GeoEduLab/3D-printed-Spectrometer/imagini/DBS23.png

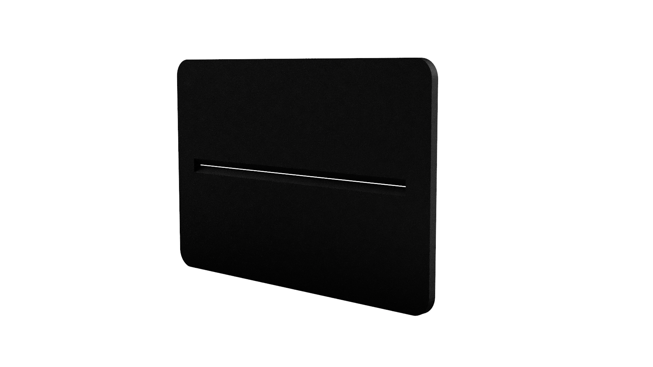
imagini/DBS23.png
