GeoEduLab/3D-printed-Spectrometer/imagini/Spectrometru_2026-Apr-17_04-58-26PM-000_CustomizedView25004581519.png

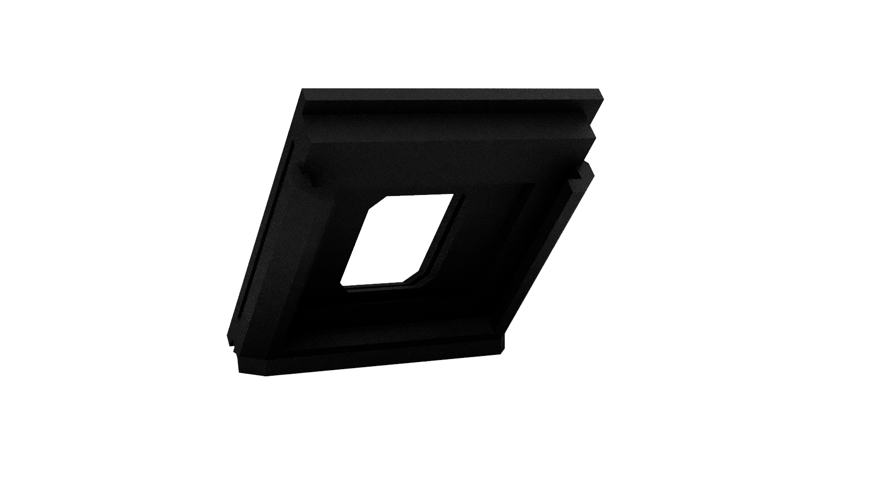
imagini/Spectrometru_2026-Apr-17_04-58-26PM-000_CustomizedView25004581519.png
