GeoEduLab/3D-printed-Spectrometer/imagini/Spectrometru_2026-Apr-17_04-58-39PM-000_CustomizedView1515149404.png

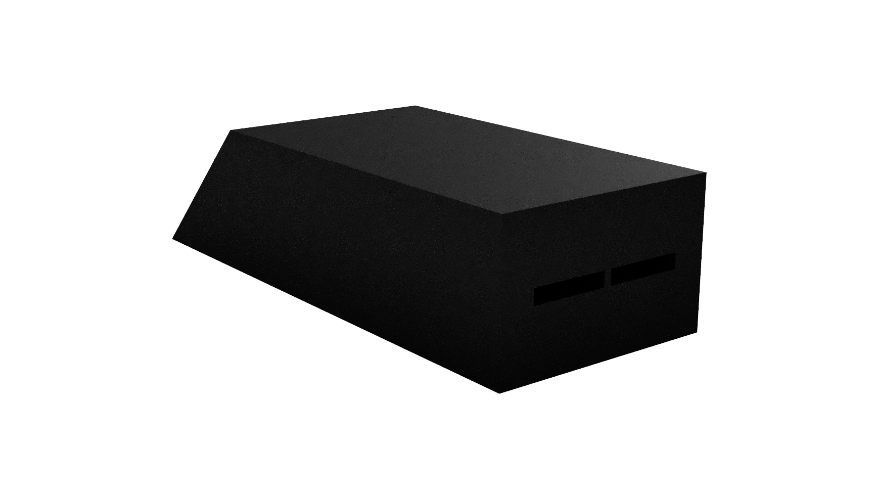
imagini/Spectrometru_2026-Apr-17_04-58-39PM-000_CustomizedView1515149404.png
