GeoEduLab/3D-printed-Spectrometer/imagini/Spectrometru_2026-Apr-17_04-59-10PM-000_CustomizedView14526760631.png

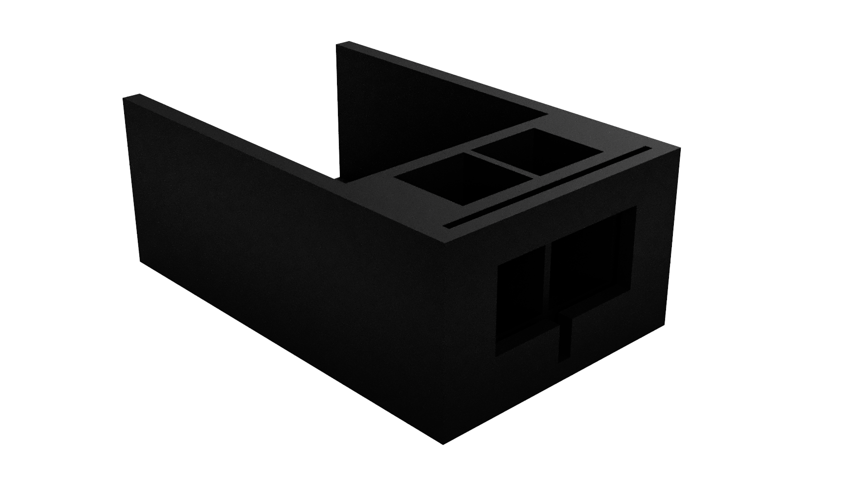
imagini/Spectrometru_2026-Apr-17_04-59-10PM-000_CustomizedView14526760631.png
