GeoEduLab/3D-printed-Spectrometer/imagini/Spectrometru_2026-Apr-17_04-59-59PM-000_CustomizedView1463442454.png

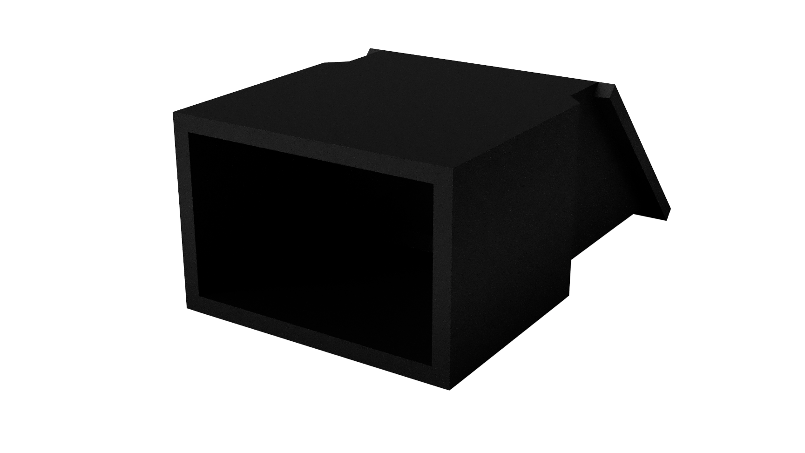
imagini/Spectrometru_2026-Apr-17_04-59-59PM-000_CustomizedView1463442454.png
