GeoEduLab/3D-printed-Spectrometer/imagini/Spectrometru_2026-Apr-17_05-00-21PM-000_CustomizedView18765208338.png

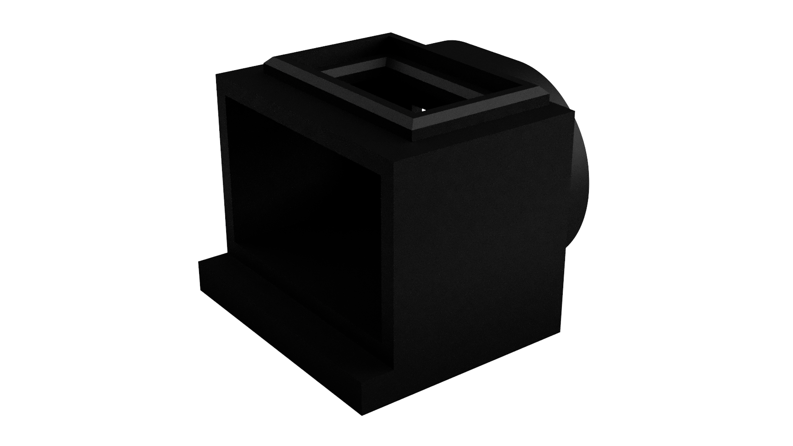
imagini/Spectrometru_2026-Apr-17_05-00-21PM-000_CustomizedView18765208338.png
