GeoEduLab/3D-printed-Spectrometer/imagini/Spectrometru_2026-Apr-17_05-00-52PM-000_CustomizedView15146700561.png

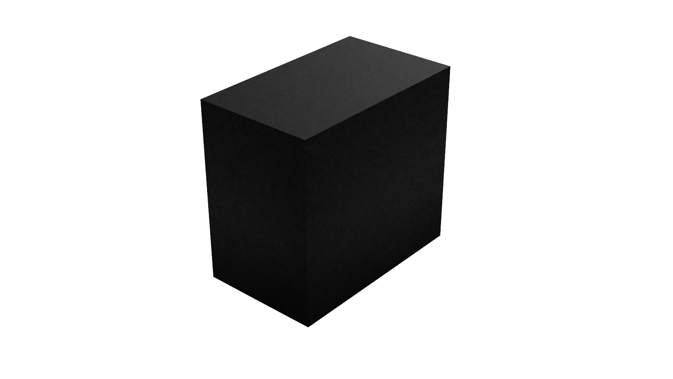
imagini/Spectrometru_2026-Apr-17_05-00-52PM-000_CustomizedView15146700561.png
