GeoEduLab/3D-printed-Spectrometer/imagini/Spectrometru_2026-Apr-17_05-02-09PM-000_CustomizedView38838320194.png

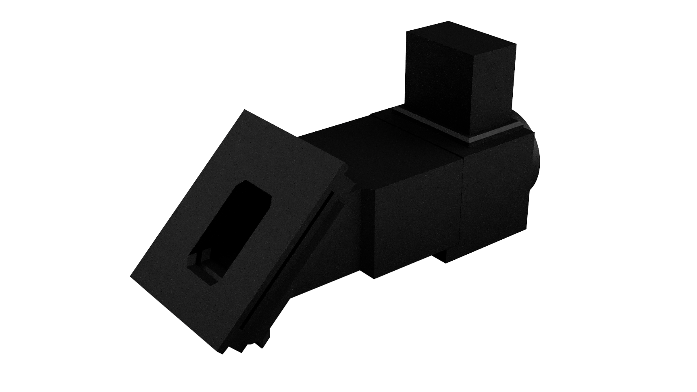
imagini/Spectrometru_2026-Apr-17_05-02-09PM-000_CustomizedView38838320194.png
