GeoEduLab/3D-printed-Spectrometer/imagini/Spectrometru_2026-Apr-17_05-02-24PM-000_CustomizedView2908652094.png

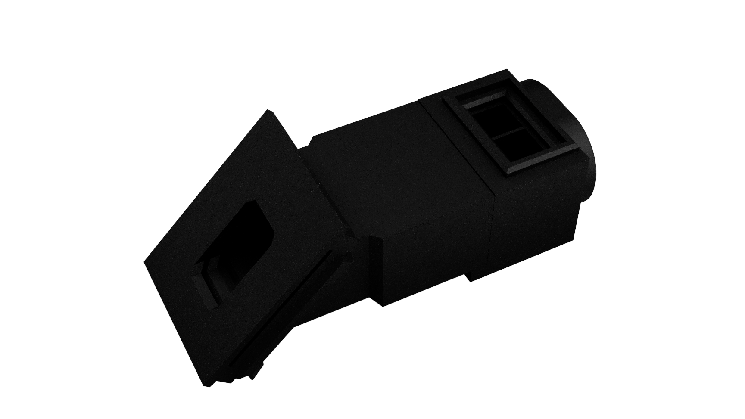
imagini/Spectrometru_2026-Apr-17_05-02-24PM-000_CustomizedView2908652094.png
