GeoEduLab/3D-printed-Spectrometer/imagini/Spectrometru_2026-Apr-17_05-02-41PM-000_CustomizedView4831055303.png

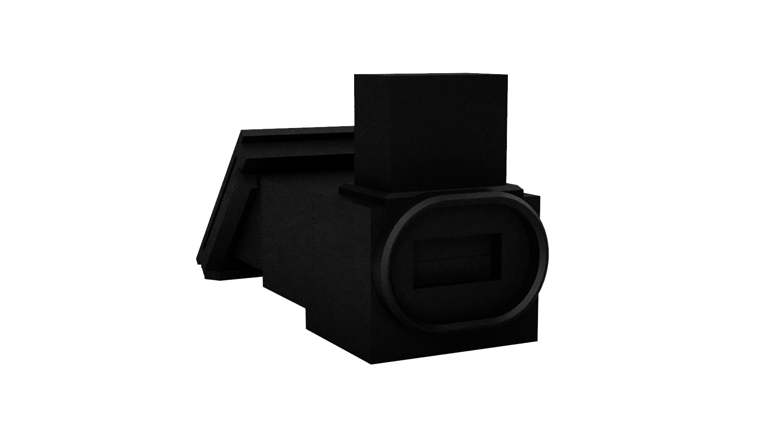
imagini/Spectrometru_2026-Apr-17_05-02-41PM-000_CustomizedView4831055303.png
