GeoEduLab/3D-printed-Spectrometer/imagini/Spectrometru_2026-Apr-17_05-03-23PM-000_CustomizedView4814271532.png

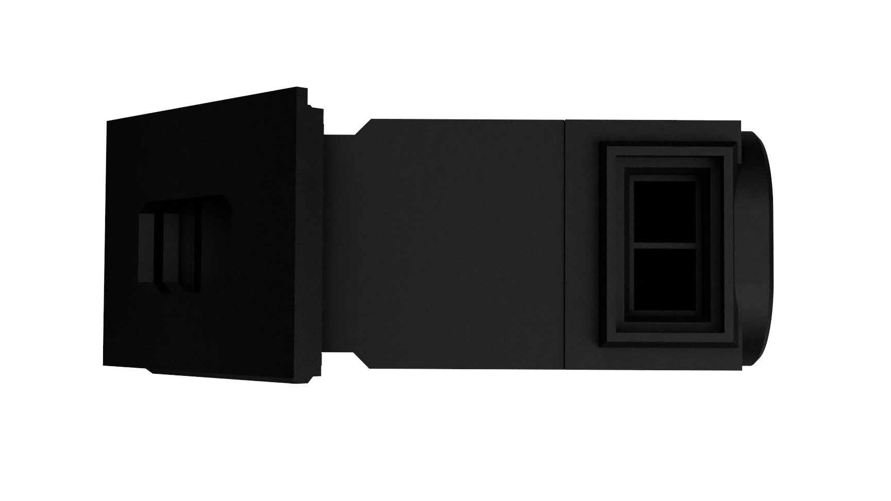
imagini/Spectrometru_2026-Apr-17_05-03-23PM-000_CustomizedView4814271532.png
