GeoEduLab/3D-printed-Spectrometer/imagini/Spectrometru_2026-Apr-17_05-08-17PM-000_CustomizedView8160718654.png

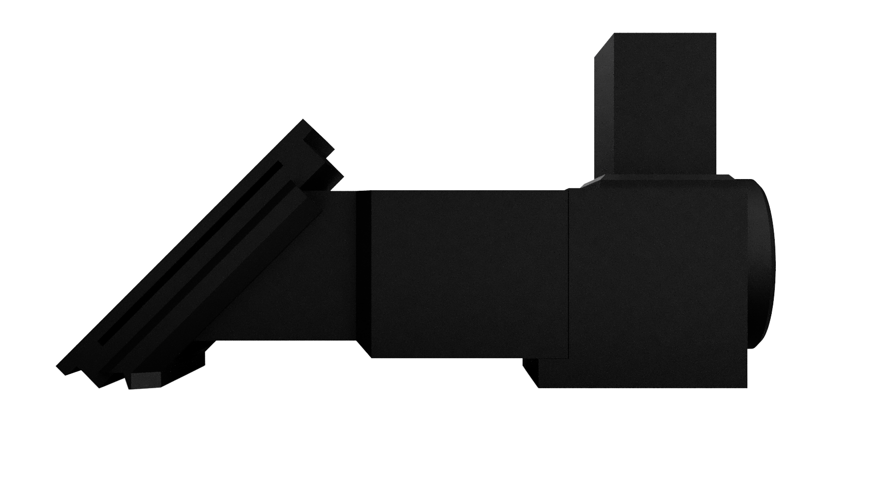
imagini/Spectrometru_2026-Apr-17_05-08-17PM-000_CustomizedView8160718654.png
