GeoEduLab/3D-printed-Spectrometer/imagini/Spectrometru_2026-Apr-17_05-12-23PM-000_CustomizedView19729545498.png

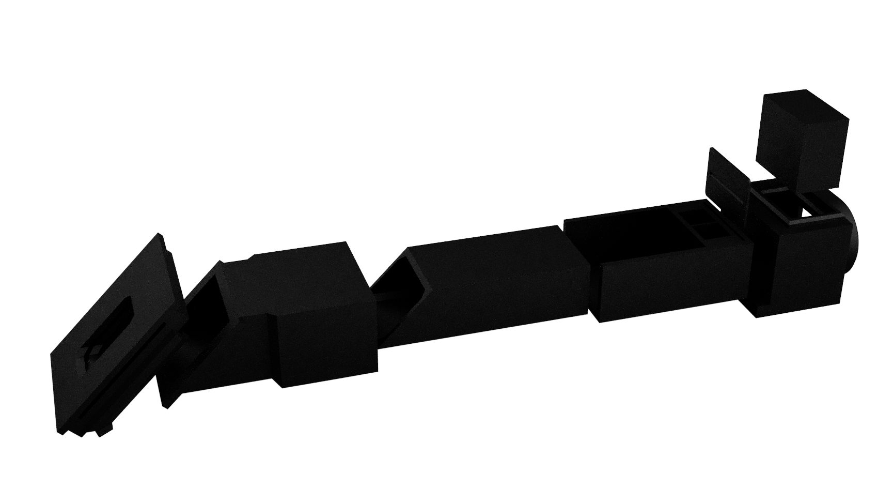
imagini/Spectrometru_2026-Apr-17_05-12-23PM-000_CustomizedView19729545498.png
