GeoEduLab/3D-printed-Spectrometer/imagini/Spectrometru_2026-Apr-17_05-12-49PM-000_CustomizedView16038114572.png

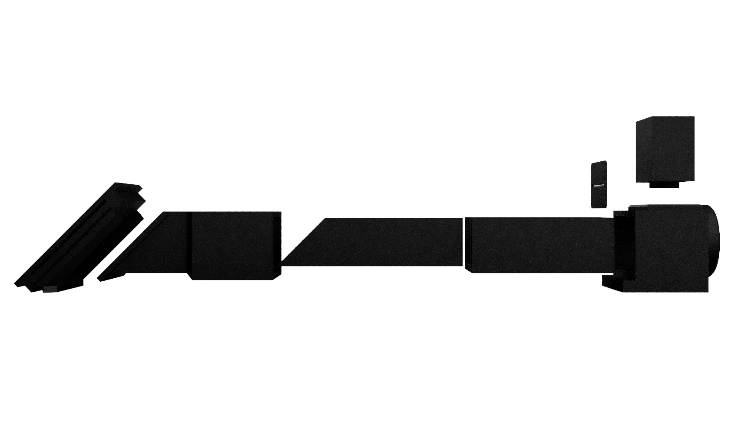
imagini/Spectrometru_2026-Apr-17_05-12-49PM-000_CustomizedView16038114572.png
