GeoEduLab/3D-printed-Spectrometer/imagini/Spectrometru_2026-Apr-17_05-12-56PM-000_CustomizedView32037252546.png

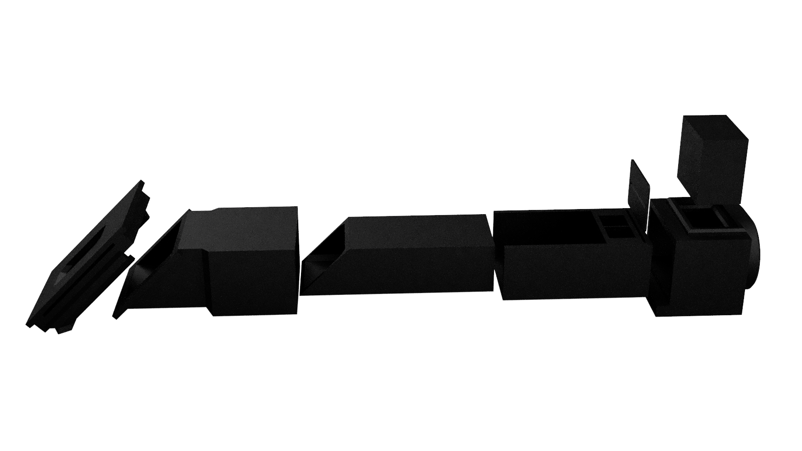
imagini/Spectrometru_2026-Apr-17_05-12-56PM-000_CustomizedView32037252546.png
