GeoEduLab/3D-printed-Spectrometer/imagini/Spectrometru_2026-Apr-17_05-13-06PM-000_CustomizedView11603945447.png

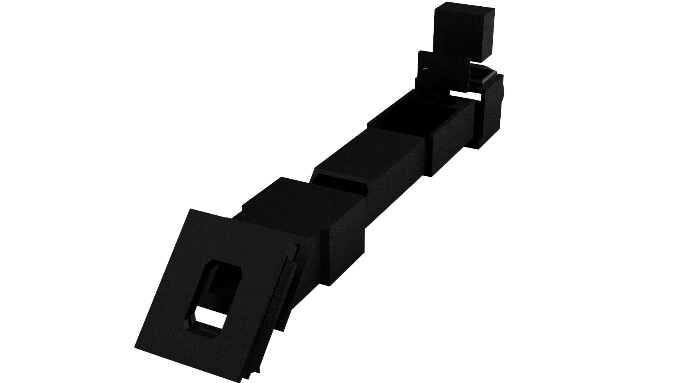
imagini/Spectrometru_2026-Apr-17_05-13-06PM-000_CustomizedView11603945447.png
