GeoEduLab/3D-printed-Spectrometer/imagini/Spectrometru_2026-Apr-17_05-13-27PM-000_CustomizedView9052108846.png

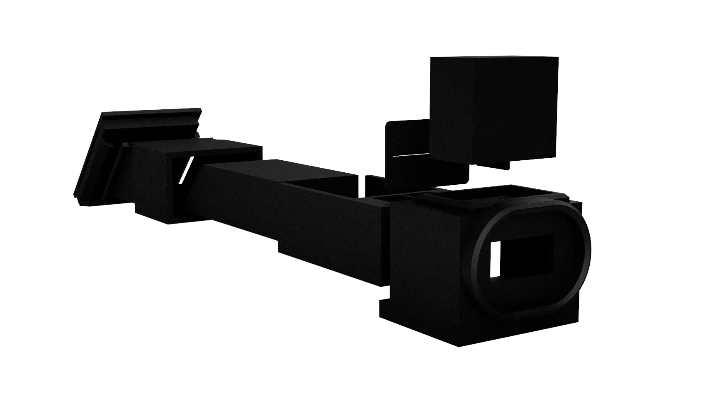
imagini/Spectrometru_2026-Apr-17_05-13-27PM-000_CustomizedView9052108846.png
