GeoEduLab/3D-printed-Spectrometer/imagini/Spectrometru_2026-Apr-17_05-33-20PM-000_CustomizedView31151100508.png

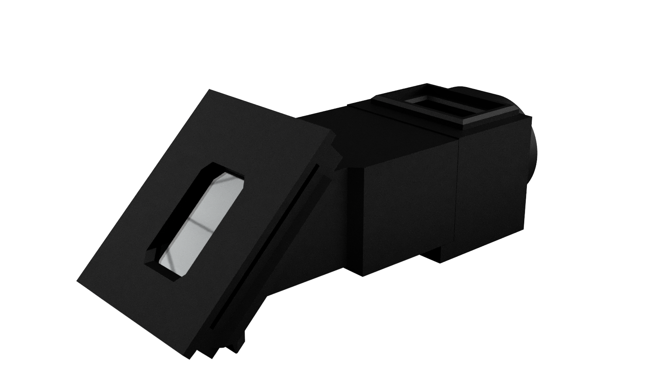
imagini/Spectrometru_2026-Apr-17_05-33-20PM-000_CustomizedView31151100508.png
