GeoEduLab/3D-printed-Spectrometer/imagini/Spectrometru_2026-Apr-17_05-33-32PM-000_CustomizedView8510036916.png

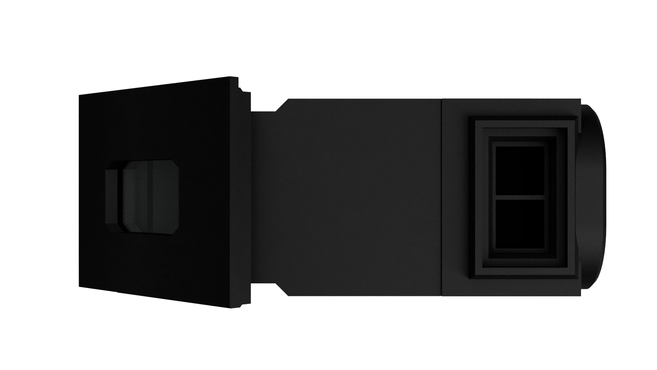
imagini/Spectrometru_2026-Apr-17_05-33-32PM-000_CustomizedView8510036916.png
