GeoEduLab/3D-printed-Spectrometer/imagini/Spectrometru_2026-Apr-17_05-35-06PM-000_CustomizedView794190731.png

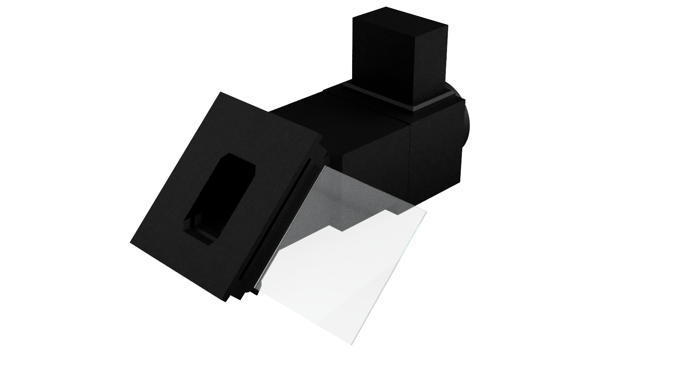
imagini/Spectrometru_2026-Apr-17_05-35-06PM-000_CustomizedView794190731.png
