GeoEduLab/3D-printed-Spectrometer/imagini/Spectrometru_2026-Apr-17_05-44-13PM-000_CustomizedView24996888186.png

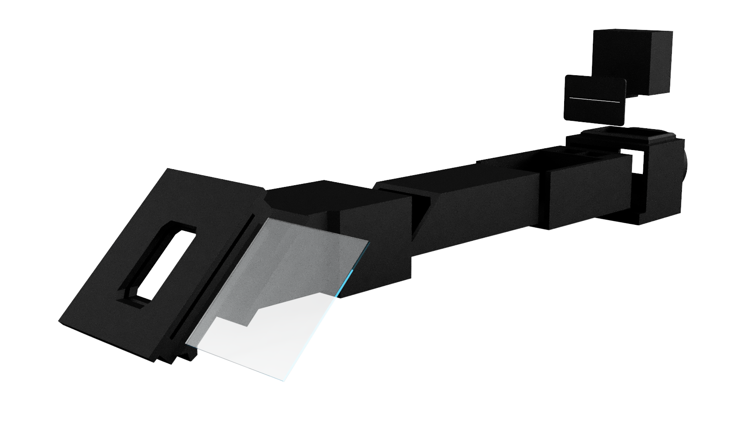
imagini/Spectrometru_2026-Apr-17_05-44-13PM-000_CustomizedView24996888186.png
