GeoEduLab/3D-printed-Spectrometer/imagini/Spectrometru_2026-Apr-17_05-44-50PM-000_CustomizedView3260356317.png

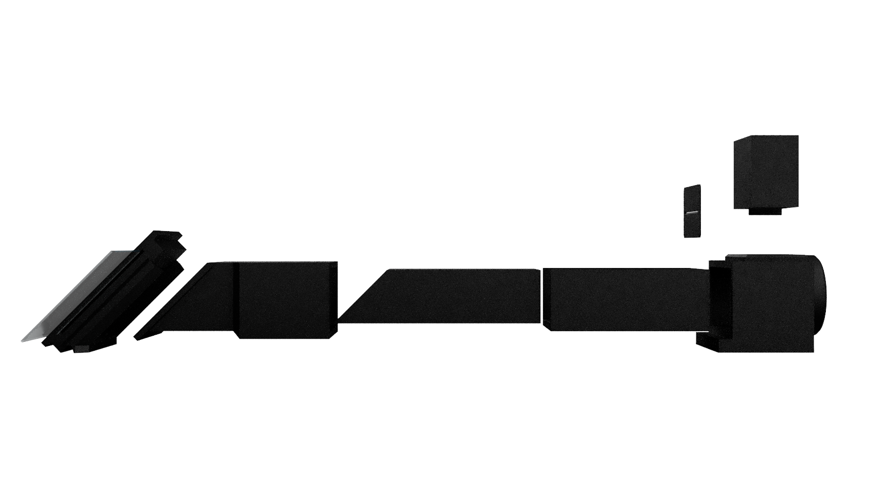
imagini/Spectrometru_2026-Apr-17_05-44-50PM-000_CustomizedView3260356317.png
