GeoEduLab/3D-printed-Spectrometer/imagini/Spectrometru_2026-Apr-17_05-45-26PM-000_CustomizedView59390768797.png

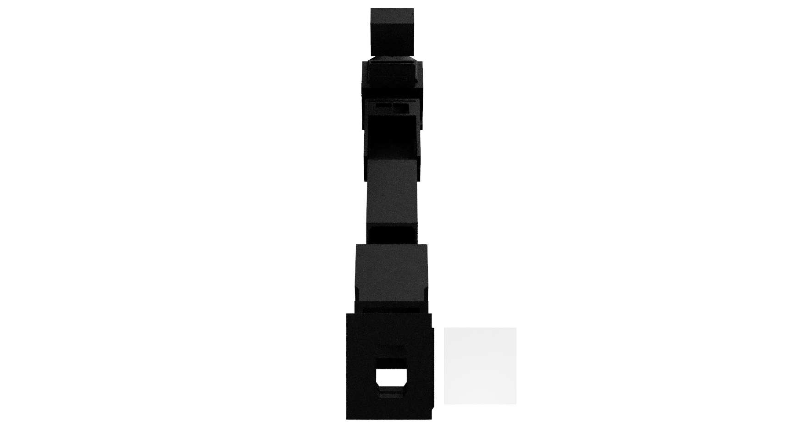
imagini/Spectrometru_2026-Apr-17_05-45-26PM-000_CustomizedView59390768797.png
