GeoEduLab/3D-printed-Spectrometer/new_parts/grating_frame/Ansamblu_rama_in_DBS03.png

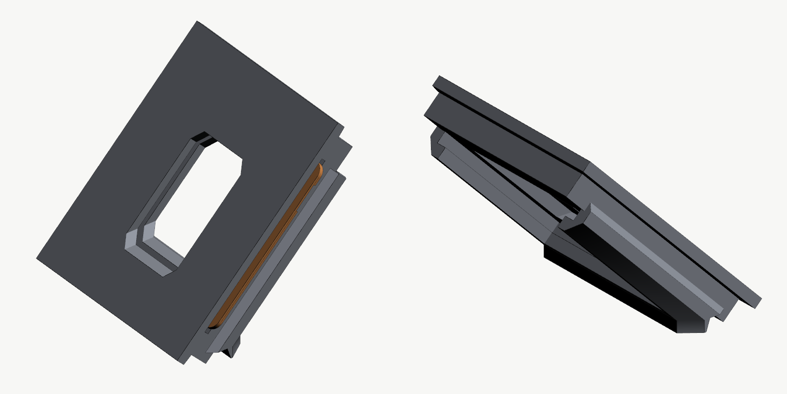
new_parts/grating_frame/Ansamblu_rama_in_DBS03.png
