GeoEduLab/3D-printed-Spectrometer/new_parts/slits/Ansamblu_fanta_in_DBS02.png

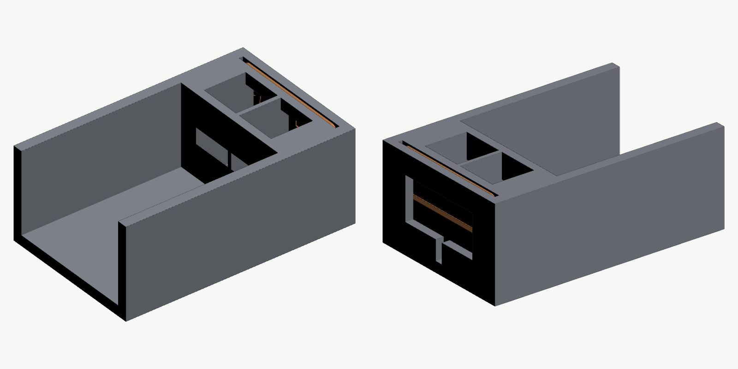
new_parts/slits/Ansamblu_fanta_in_DBS02.png
