GeoEduLab/3D-printed-Spectrometer/new_parts/grating_frame/jig_capac.stl

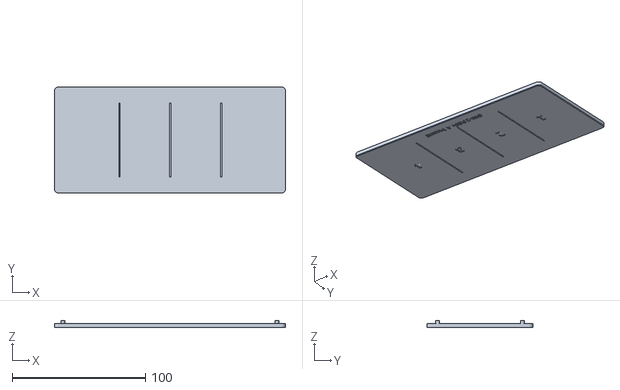
[picture p29: CAD file, 2026-11-09]
new_parts/grating_frame/jig_capac.stl
173.6 x 79.6 x 5.60
