GeoEduLab/3D-printed-Spectrometer/new_parts/slits/fanta_1.stl

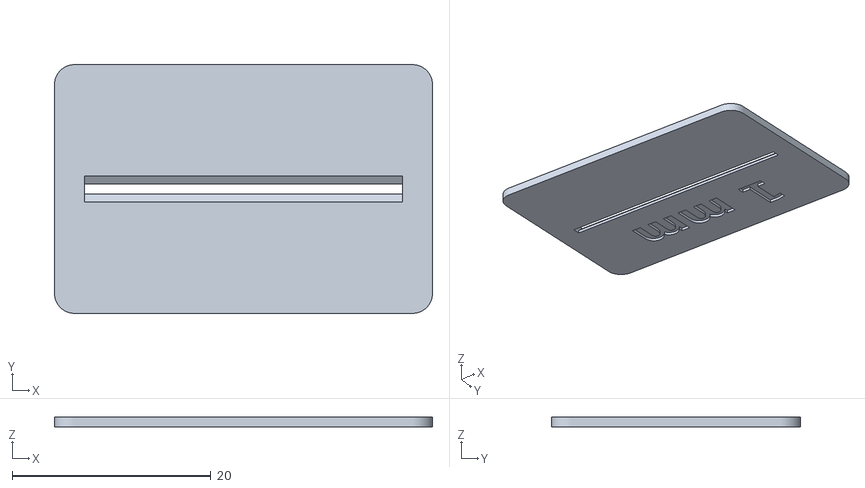
[picture p30: CAD file, 2026-11-09]
new_parts/slits/fanta_1.stl
38.0 x 25.0 x 1.00
