GeoEduLab/3D-printed-Spectrometer/new_parts/grating_frame/RamaRetea_4rame_v1.5_H2S.3mf

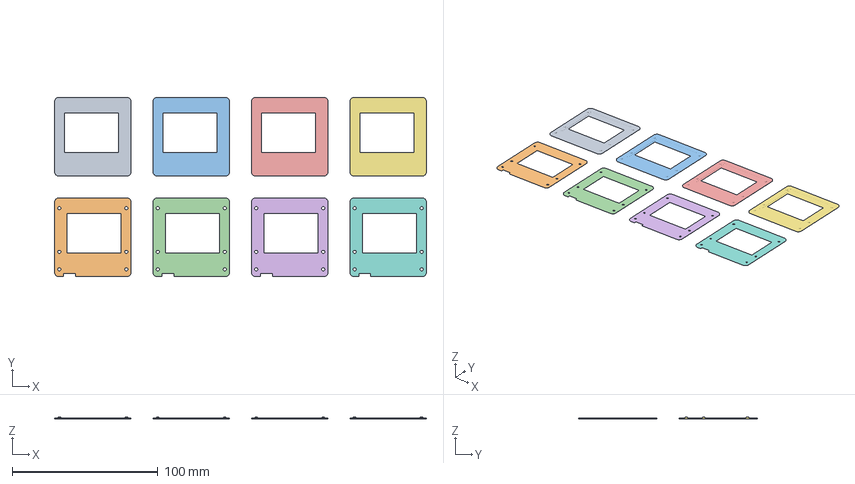
[picture p31: CAD file, 2026-11-09]
new_parts/grating_frame/RamaRetea_4rame_v1.5_H2S.3mf
255.4 x 123.1 x 1.28 mm
rama1_A
rama1_B
rama2_A
rama2_B
rama3_A
rama3_B
rama4_A
rama4_B
