GeoEduLab/3D-printed-Spectrometer/new_parts/grating_frame/jig_baza.stl

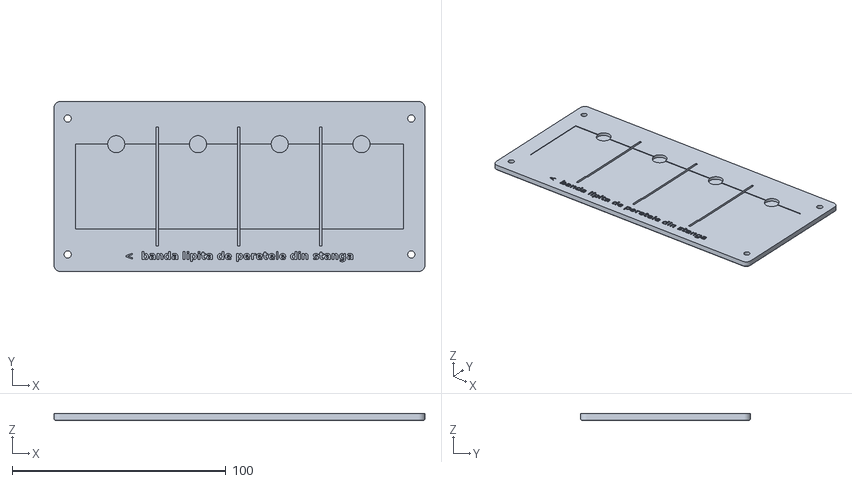
[picture p33: CAD file, 2026-11-09]
new_parts/grating_frame/jig_baza.stl
173.6 x 79.6 x 3.20
