GeoEduLab/3D-printed-Spectrometer/new_parts/slits/Fante_v0.5_H2S.3mf

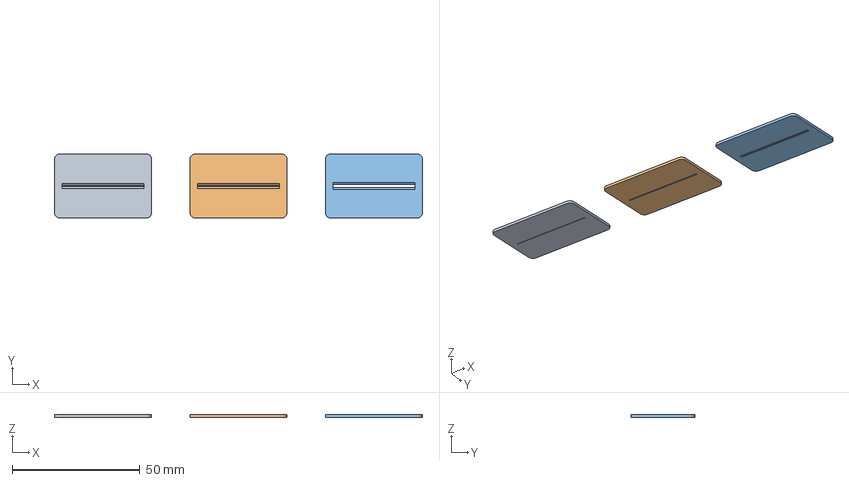
[picture p34: CAD file, 2026-11-09]
new_parts/slits/Fante_v0.5_H2S.3mf
144.0 x 25.0 x 1.00 mm
fanta_0.25
fanta_0.5
fanta_1
