GeoEduLab/3D-printed-Spectrometer/new_parts/grating_frame/rama_A.stl

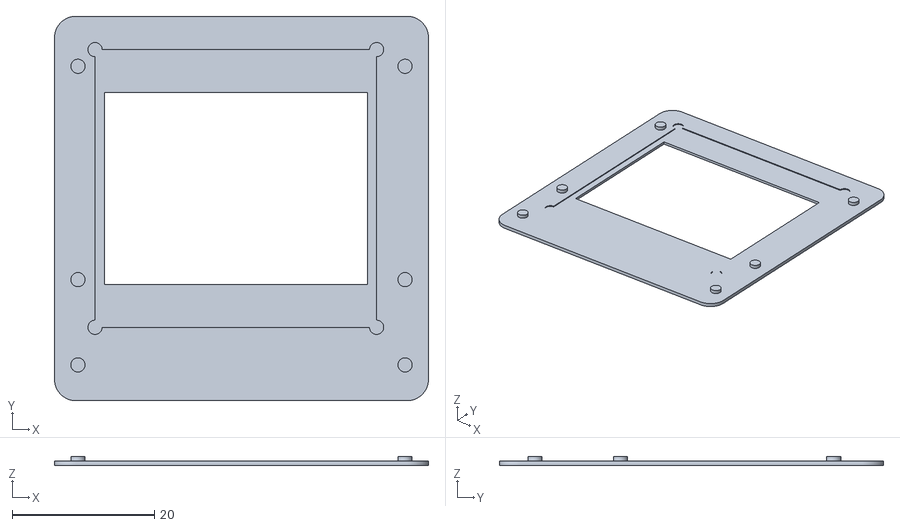
[picture p35: CAD file, 2026-11-09]
new_parts/grating_frame/rama_A.stl
52.6 x 54.0 x 1.28
