GeoEduLab/3D-printed-Spectrometer/new_parts/slits/Fante_proba12_v0.5_H2S.3mf

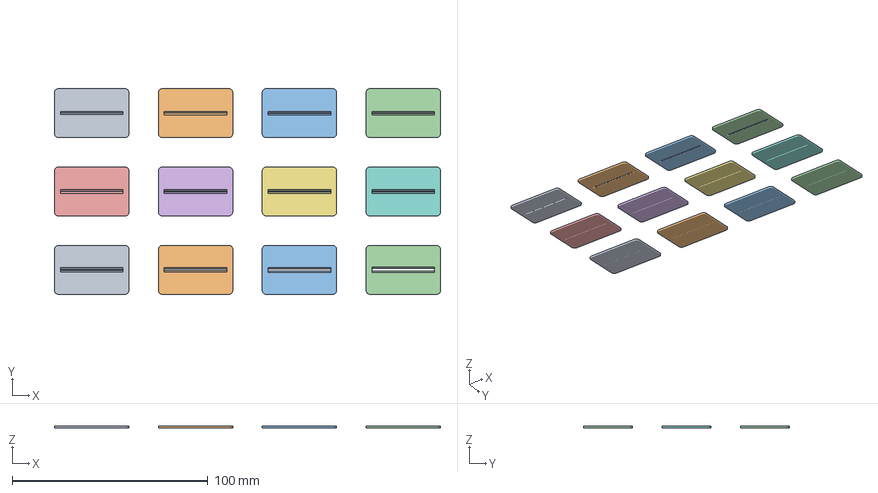
[picture p36: CAD file, 2026-11-09]
new_parts/slits/Fante_proba12_v0.5_H2S.3mf
197.0 x 105.0 x 1.00 mm
fanta_0.05
fanta_0.1
fanta_0.15
fanta_0.2
fanta_0.25
fanta_0.3
fanta_0.4
fanta_0.5
fanta_0.6
fanta_0.8
fanta_1
fanta_1.2
