GeoEduLab/3D-printed-Spectrometer/new_parts/grating_frame/RamaRetea_jig_v1.5_H2S.3mf

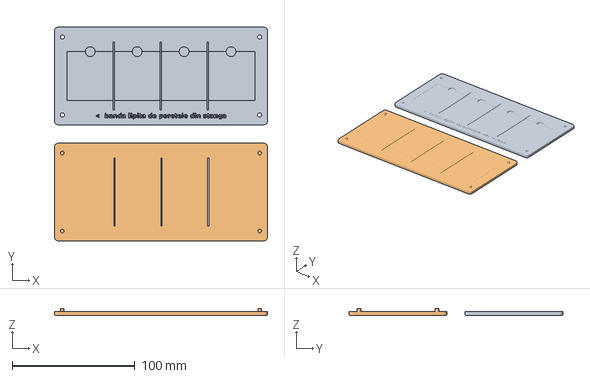
[picture p37: CAD file, 2026-11-09]
new_parts/grating_frame/RamaRetea_jig_v1.5_H2S.3mf
173.6 x 174.2 x 5.60 mm
geometry_0
geometry_1
