GeoEduLab/3D-printed-Spectrometer/new_parts/slits/fanta_0.25_text.stl

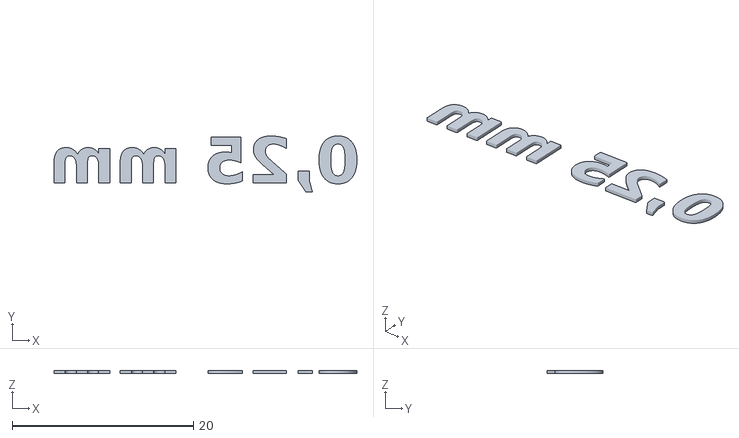
[picture p38: CAD file, 2026-11-09]
new_parts/slits/fanta_0.25_text.stl
33.4 x 6.19 x 0.36
