GeoEduLab/3D-printed-Spectrometer/new_parts/grating_frame/rama_B_text.stl

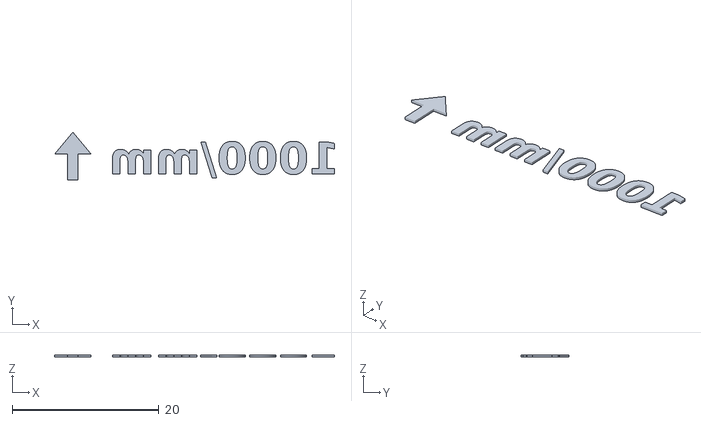
[picture p39: CAD file, 2026-11-09]
new_parts/grating_frame/rama_B_text.stl
38.1 x 6.50 x 0.32
