GeoEduLab/3D-printed-Spectrometer/new_parts/grating_frame/rama_B.stl

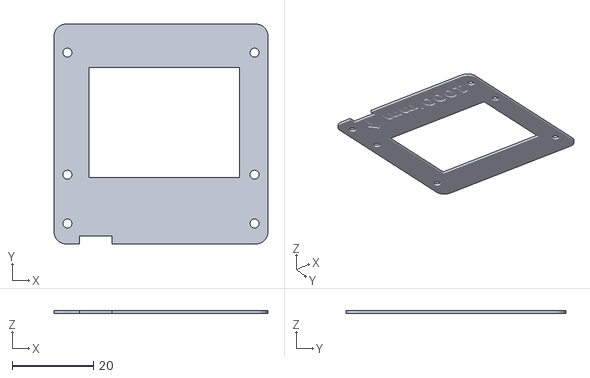
[picture p40: CAD file, 2026-11-09]
new_parts/grating_frame/rama_B.stl
52.6 x 54.0 x 0.64
