GeoEduLab/3D-printed-Spectrometer/new_parts/slits/fanta_1_text.stl

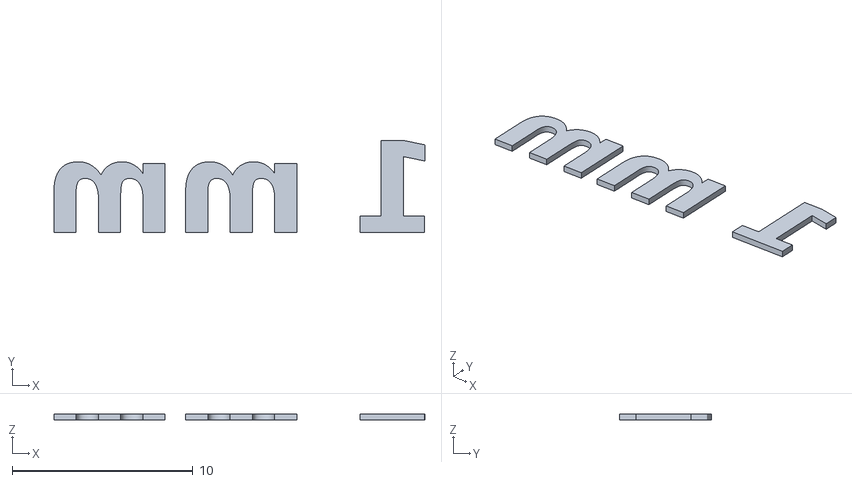
[picture p41: CAD file, 2026-11-09]
new_parts/slits/fanta_1_text.stl
20.6 x 5.10 x 0.36
