GeoEduLab/3D-printed-Spectrometer/new_parts/slits/fanta_0.5_text.stl

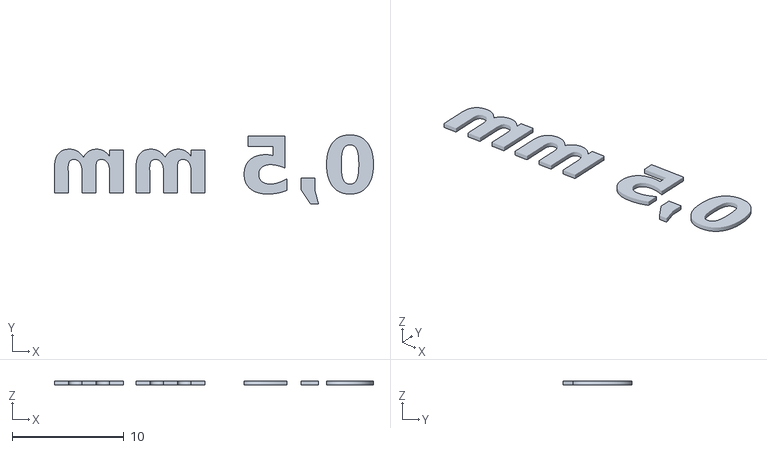
[picture p42: CAD file, 2026-11-09]
new_parts/slits/fanta_0.5_text.stl
28.5 x 6.19 x 0.36
