GeoEduLab/3D-printed-Spectrometer/(list of files, cad)

Other CAD files:
new_parts/slits/fanta_0.25.stl
new_parts/grating_frame/RamaRetea_jig_v1.5.3mf
new_parts/grating_frame/RamaRetea_4rame_v1.5.3mf
new_parts/slits/proba_latimi.3mf
new_parts/slits/Fante_0.25_0.5_1.3mf
