GeoEduLab/3D-printed-Spectrometer/Smartspectrometer-Manual-RO.pdf

# Spectrofotometrul cu dublă rază

Manual de asamblare și utilizare pentru elevi și profesori


Manual v1 · 2026 | Licență hardware: CC BY-SA 4.0

Bazat pe: Winters, B.J. et al. (2021). 3D-Printable and open-source modular smartphone visible spectrophotometer. HardwareX, 10, e00232. https://doi.org/10.1016/j.ohx.2021.e00232

Fișiere STL și documentație: https://osf.io/7ewb3

SMARTSPECTROMETER · GEO EDU LAB | 1
geoedulab.infp.ro | CC BY-SA 4.0

### Cuprins

1. Ce este lumina?
2. Ce este un spectrofotometru?
3. Cum funcționează spectrofotometrul nostru?
4. Componentele spectrofotometrului
5. Asamblarea pas cu pas
6. Cum măsurăm?
7. Calibrarea instrumentului
8. Experimente
9. Depanare: Ce fac dacă nu merge?
10. Referințe
SMARTSPECTROMETER · GEO EDU LAB | 2

### 1. Ce este lumina?

Lumina este o formă de energie care călătorește sub formă de unde electromagnetice. Ceea ce vedem cu ochii noștri, culorile curcubeului, de la violet la roșu, reprezintă doar o mică porțiune dintr-un spectru mult mai larg.

Lungimea de undă (nm):
100 | 400 | 450 | 500 | 550 | 600 | 650 | 700 | 1000+
[UV extrem] [Violet][Albastru][Verde][Galben][Portocaliu][Roșu] [Infraroșu] ←——————— Vizibil pentru ochiul uman (380–700 nm) ————————→

💡 Știați că? Curcubeul nu este altceva decât lumina soarelui separată în culorile sale componente de picăturile de ploaie, care acționează ca niște prisme minuscule. Spectrofotometrul nostru face același lucru, dar în laborator!

💡 Știați că? Corpul uman emite lumină! Orice obiect cu o temperatură mai mare de −273°C (zero absolut) emite radiație electromagnetică. Corpul uman, la ≈37°C, emite lumină infraroșie, invizibilă ochiului, dar detectabilă cu camere termice. Acest fenomen se numește radiație de corp negru (black body radiation), descris de fizicianul Max Planck în 1900.
Cu cât un obiect este mai cald, cu atât lungimea de undă dominantă este mai scurtă:

Corpul uman (≈37°C) → infraroșu (≈9.000 nm)
Un fier înroșit (≈700°C) → roșu vizibil (≈700 nm)

Soarele (≈5.500°C) → galben-verde (≈500 nm)

O stea albastră fierbinte (≈20.000°C) → ultraviolet

Spectroscopia ne permite să „citim" temperatura și compoziția chimică a oricărei surse de lumină!

SMARTSPECTROMETER · GEO EDU LAB | 3

### 2. Ce este un spectrofotometru?

Un spectrofotometru este un instrument care:

1. Separă lumina în culorile sale componente (spectru)
2. Măsoară cât de multă lumină absoarbe sau emite o substanță la fiecare culoare (lungime de undă)

Există două tipuri principale de măsurători pe care le putem face:

Tip de
spectroscopie
| Ce măsurăm | Exemple
Emisie | Lumina produsă direct de o sursă | Becuri, flăcări, plasma, stele
Absorbție | Lumina absorbită de o substanță transparentă | Soluții colorate, filtre, clorofilă

💡 Știați că? Fiecare atom are o „amprentă digitală" de lumină! Atomii emit și absorb lumină numai la anumite lungimi de undă precise, ca un cod de bare unic. Aceasta a permis oamenilor de știință să descopere elementele chimice din Soare și stele fără să le viziteze vreodată! De exemplu, heliul a fost descoperit mai întâi pe Soare (în 1868) și abia 27 de ani mai târziu pe Pământ.

Această capacitate face spectrofotometrul util în:

Chimie: determinarea concentrației soluțiilor Biologie: analiza pigmenților, clorofilei, proteinelor

Astronomie: identificarea elementelor din stele Criminalistică: analiza urmelor de substanțe
Industria alimentară: controlul calității

Spectrofotometrele comerciale costă între 400 și 6.000 de euro [1]. Cel pe care îl construim noi costă aproximativ 25 de euro pentru piese și folosește smartphone-ul ca detector, fără să sacrifice precizia [1].

SMARTSPECTROMETER · GEO EDU LAB | 4

### 3. Cum funcționează spectrofotometrul nostru?

Spectrofotometrul DBS (Double-Beam Spectrophotometer, Spectrofotometru cu Dublă Rază) funcționează astfel:

SURSA DE LUMINA
│
▼
[Fanta ingusta] ← cartonas tiparit 3D (0,25 / 0,5 / 1 mm) │
│ raza 1 → trece prin PROBA (solutia de analizat) [Suport proba]
│ raza 2 → trece prin REFERINTA (apa pura / solvent)
│
▼
[Retea de difractie] ← 1000 linii/mm; separa culorile ca o prisma │
▼
[Camera smartphone / USB]
│
▼
[Software ImageJ] → grafic intensitate vs. lungime de unda
[Ochi] | → spectru vizibil direct in imagine

Notă pentru spectroscopia de emisie: Când studiem lumina emisă direct de o sursă (bec, flacără, plasmă), nu mai este nevoie de cuve cu probe. Îndreptăm spectrofotometrul direct spre sursă și observăm spectrul de emisie al acesteia.

Ce este rețeaua de difracție?

O rețea de difracție este o suprafață cu mii de linii paralele gravate pe milimetru. Când lumina lovește aceste linii, diferitele lungimi de undă (culori) sunt deviate în unghiuri diferite, exact ca o prismă, dar mai eficient. Rețeaua noastră are 1000 de linii pe milimetru [1].

De ce „dublă rază"?

Designul cu două raze este esențial pentru precizie în spectroscopia de absorbție [1]:

Raza superioară trece prin proba de analizat
Raza inferioară trece prin referință (apă pură sau solvent)
SMARTSPECTROMETER · GEO EDU LAB | 5

Camera captează ambele raze simultan în aceeași imagine. Comparând cele două spectre, eliminăm erorile cauzate de fluctuațiile sursei de lumină.

Legea Beer-Lambert: relația dintre culoare și concentrație

Cu cât o soluție este mai concentrată, cu atât absoarbe mai multă lumină. Această relație este descrisă prin Legea Beer-Lambert [1]:

Absorbanță (A) = −log₁₀ (P / P₀)

P₀ = intensitatea luminii de referință

P = intensitatea luminii după ce trece prin probă Absorbanță = 1 → proba a absorbit 90% din lumină Absorbanță = 2 → proba a absorbit 99% din lumină

SMARTSPECTROMETER · GEO EDU LAB | 6

### 4. Componentele spectrofotometrului

Spectrofotometrul este format din piese imprimate 3D și câteva componente achiziționate. Iată piesele principale:

### 4.1 Tubul fantă (DBS01)


Tub dreptunghiular alungit cu capătul tăiat în unghi; fața oblică permite intrarea luminii din fantă și o

îndreaptă spre probă.

Rol: Ghidează lumina de la sursă spre probă, menținând fasciculul îngust și drept. Se montează în Suportul probă și se interblocă cu Adaptorul tub (DBS04) pentru rigiditate.

### 4.2 Suportul probă și suportul fantei (DBS02)


Bloc dreptunghiular masiv cu două compartimente vizibile în partea dreaptă sus; acestea sunt sloturile pentru cuvele cu probă și referință. DBS02 găzduiește totodată cartonașul cu fantă.

Rol: Piesa centrală a instrumentului. Conține două sloturi pentru cuve (probă și referință) și găzduiește direct cartonașul cu fantă. Lumina trece prin fantă și prin ambele cuve simultan, creând cele două raze.

### 4.3 Suportul rețelei de difracție (DBS03)

SMARTSPECTROMETER · GEO EDU LAB | 7


Placă dreptunghiulară cu o fereastră/deschidere centrală prin care se introduce rețeaua de difracție.

Marginile în trepte asigură fixarea precisă a unghiului față de fasciculul de lumină.

Rol: Ține rețeaua de difracție (foița cu 1000 linii/mm) în unghiul corect față de fasciculul de lumină. Pe el se montează și suportul pentru cameră/smartphone.

### 4.4 Adaptorul tub (DBS04)


Cutie cubică cu o față tăiată în unghi și deschisă; creează camera întunecată dintre suportul probei și rețeaua de difracție, izolând fasciculul de lumina ambientală.

Rol: Face legătura mecanică între Suportul probă și Suportul rețelei de difracție. Tubul fantă (DBS01) se prelungește prin acesta și se interblocă cu DBS03, asigurând rigiditate și etanșeitate la lumina ambientală [1].

### 4.5 Adaptorul sursă (DBS05)


Bloc cubic cu o deschidere ovală pe fața frontală (pentru sursa de lumină) și un mâner/suport pe partea

superioară. Forma ovală centrează fasciculul de lumină spre fantă.

SMARTSPECTROMETER · GEO EDU LAB | 8

Rol: Se montează pe capătul suportului probă dinspre sursa de lumină. Adaptează diferite tipuri de surse (lanternă, stilou LED) la corpul instrumentului.

### 4.6 Cartonașele cu fantă (0,25 / 0,5 / 1 mm)


Trei cartonașe tipărite 3D, de 38 × 25 × 1 mm, fiecare cu o fantă de 32 mm lungime și lățimea gravată pe el. Se pun în locașul fantei din Suportul probă (DBS02), înaintea probei. Fișierele sunt în dosarul

new_parts/slits al acestui repository.

Rol: Cartonașul are fanta de lumină, cea mai delicată parte a instrumentului. Lățimea fantei determină rezoluția spectrală: o fantă îngustă dă linii mai subțiri, dar lasă să treacă mai puțină lumină.

De ce 0,25 / 0,5 / 1 mm: imprimanta (duza de 0,4 mm) închide complet o fantă de 0,05 mm. De la 0,1 mm în sus golul tipărit urmează desenul, dar pe piesă iese ceva mai îngust, iar sub ~0,2 mm marginile se pot lipi. De aceea cea mai îngustă fantă are 0,25 mm, iar fiecare următoare e de două ori mai lată, ca diferența să se vadă cu ochiul.

💡 Experimentați! Măsurați același bec cu toate trei cartonașele și comparați lățimea liniilor și cât de luminos e spectrul. Cu cartonașul de probă (12 lățimi, de la 0,05 la 1,2 mm) puteți afla ce lățimi deschide de fapt imprimanta voastră: îl țineți în fața unui bec și păstrați fantele deschise pe toată lungimea.

### 4.7 Cuve (CV01)

SMARTSPECTROMETER · GEO EDU LAB | 9

Cuve de unică folosință din PMMA (Polimetacrilat de metil), volum 2,5–4,5 ml, cu drum optic standard de 10

mm.

Rol: Conțin probele lichide (și soluția de referință) în timpul măsurătorilor de absorbție. Cuvele PMMA sunt transparente în domeniul vizibil (380–700 nm) și sunt de unică folosință, prevenind contaminarea încrucișată între experimente.

### 4.8 Rama rețelei de difracție și jig-ul de tăiat

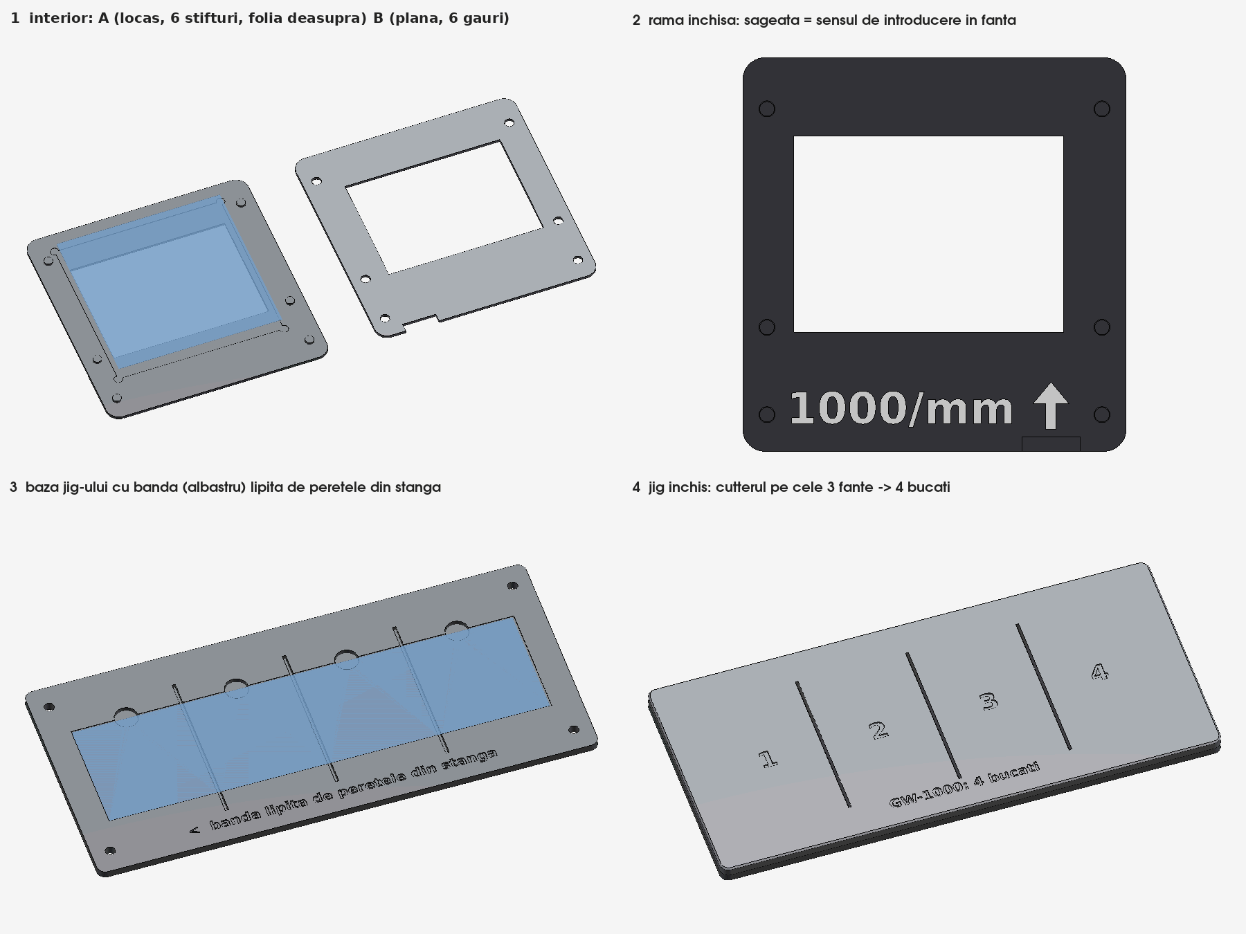
[picture p80: figure]

Rama tipărită din două jumătăți (A cu locaș și 6 știfturi, B plană cu scrisul alb „1000/mm" și o săgeată) și jig-ul care taie banda de folie în 4 bucăți egale. Fișierele sunt în dosarul new_parts/grating_frame .

Rol: Ține bucata de folie de difracție (AstroMedia GW-1000, 1000 linii/mm) plană și la locul ei în fanta laterală a lui DBS03, în locul ramei de carton din kit. Fereastra de 37 × 27 mm e centrată pe deschiderea lui DBS03, iar capătul cu crestătură rămâne ~2 mm afară, ca să scoateți rama ușor.

SMARTSPECTROMETER · GEO EDU LAB | 10

### 5. Asamblarea pas cu pas

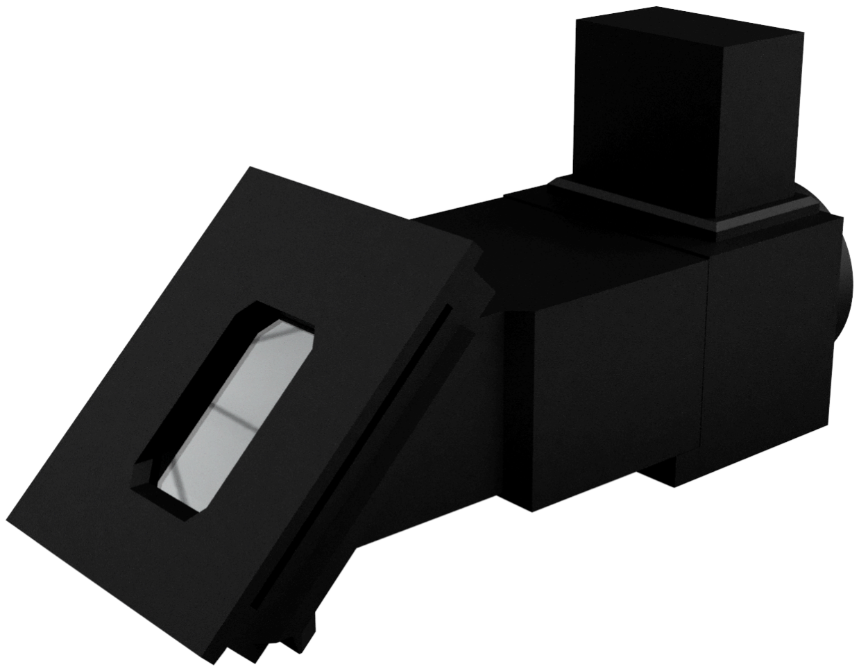
[picture p81: figure]

Spectrofotometrul complet asamblat. Se observă fanta de lumină (deschiderea dreptunghiulară albă) pe fața frontală și suportul pentru cameră/smartphone montat deasupra corpului principal.

Pasul 0: Pregătirea rețelei de difracție (rama și jig-ul)

Ai nevoie de: banda de folie GW-1000 (153 × 39 mm), jig-ul (bază + capac), o ramă (jumătățile A și B), un cutter, o pensetă

0a. Puneți banda în buzunarul bazei jig-ului și împingeți-o în peretele din stânga (săgeata gravată). Țineți folia doar de margini.

0b. Puneți capacul: cele 4 știfturi intră în găurile bazei, iar cifrele 1–4 trebuie să se citească corect.

0c. Trageți cutterul prin fiecare din cele 3 fante; lama coboară într-un canal din bază și taie folia până la capăt. Ridicați bucățile (38,25 × 39 mm) cu penseta.

0d. Puneți o bucată în locașul din jumătatea A și apăsați B peste A, cu scrisul în afară. Știfturile intră presat, fără lipici.

Rezultat: Rama cu rețeaua este gata. Din bandă ies 4 rame. ✓

Pasul 1: Montarea cartonașului cu fantă

Ai nevoie de: DBS02 (1×), un cartonaș cu fantă (0,25, 0,5 sau 1 mm; pentru început 0,5 mm)

SMARTSPECTROMETER · GEO EDU LAB | 11

1a. Verificați că DBS02 și cartonașul sunt curate și fără bavuri după imprimare, iar fanta se vede deschisă pe toată lungimea când țineți cartonașul spre un bec.

1b. Introduceți cartonașul în locașul fantei din DBS02, înaintea poziției probei. Fanta trebuie să fie orizontală.

1c. Împingeți până la fund: cartonașul rămâne puțin sub marginea lui DBS02. Pentru schimbare, scoateți-l întorcând DBS02.

Rezultat: Cardul cu fantă este montat; lumina va trece prin fanta imprimată spre cuve. ✓

💡 Alternativă: Puteți decupa și o fantă din carton negru cu un cutter, pentru a o compara cu cele tipărite.

Pasul 2: Asamblarea corpului principal

Ai nevoie de: subansamblul de la Pasul 1, DBS01, DBS03, DBS04, DBS05, rama cu rețeaua (Pasul 0)

2a. Verificați că DBS02 are cartonașul cu fantă montat (Pasul 1).

2b. Introduceți DBS01 (Tubul fantă) în DBS02 în orientarea corectă (consultați Fig. 4 din articol [1]).

2c. Montați DBS03 pe DBS04, apoi introduceți acest ansamblu pe DBS02 + DBS01. Tubul DBS01 se va prelungi dincolo de DBS04, interblocând totul; aceasta asigură rigiditate și etanșeitate la lumina ambientală [1].

2d. Introduceți rama cu rețeaua în fanta laterală a lui DBS03, cu vârful săgeții înainte, până la fund; capătul cu crestătură rămâne ~2 mm afară.

⚠️ Important: Liniile rețelei trebuie să fie orizontale în DBS03. Locașul ramei primește bucata de folie în ambele orientări, așa că verificați la un bec înainte de măsurători: dacă spectrul iese greșit, desfaceți rama și rotiți bucata cu 90°.

2e. Introduceți DBS05 (Adaptorul sursă) pe capătul opus al DBS02.

2f. Apăsați ansamblul din ambele capete pentru a vă asigura că toate piesele sunt bine fixate.

Rezultat: Instrumentul de bază este complet asamblat! ✓

SMARTSPECTROMETER · GEO EDU LAB | 12


Spectrofotometru complet asamblat. Fanta de lumină (deschiderea dreptunghiulară albă) este vizibilă pe fața

frontală, cu suportul pentru cameră/smartphone montat pe partea superioară a corpului principal.

SMARTSPECTROMETER · GEO EDU LAB | 13

### 6. Cum măsurăm?

### 6.1 Spectroscopia de emisie (fără cuve)

Folosită pentru a studia lumina produsă direct de o sursă (bec, flacără, LED, tub de descărcare).

Procedură:

1. Îndreptați spectrofotometrul spre sursa de lumină
2. Porniți camera și așteptați 30 de secunde ca imaginea să se stabilizeze
3. Capturați imaginea; veți vedea banda colorată a spectrului de-a lungul imaginii
4. Dacă imaginea este supraexpusă (albă), reduceți ISO-ul sau timpul de expunere al camerei

### 6.2 Spectroscopia de absorbție (cu cuve)

Folosită pentru a studia cât de multă lumină absoarbe o soluție.

Pregătirea probei:

Umpleți o cuvă cu proba (soluția de analizat)
Umpleți o altă cuvă cu referința (apă pură sau solventul pur)
Plasați cuva cu proba în slotul superior, referința în slotul inferior al DBS02

Capturarea imaginii:

1. Porniți sursa de lumină (lanternă sau stilou LED alb)
2. Așteptați 30 de secunde
3. Capturați imaginea; trebuie să fie vizibile ambele benzi spectrale (proba sus, referința jos)

### 6.3 Software și extragerea datelor

ImageJ, gratuit, open-source, disponibil la https://imagej.nih.gov/

1. Deschideți imaginea capturată în ImageJ
2. Cu instrumentul Rectangle, selectați o bandă orizontală de 200 pixeli înălțime pe toată lățimea imaginii
3. Mergeți la Analyze → Plot Profile (sau apăsați Ctrl+K)
4. În fereastra graficului, dați clic pe "Data" → "Copy All Data"
5. Lipiți datele în Microsoft Excel sau LibreOffice Calc
SMARTSPECTROMETER · GEO EDU LAB | 14

### 6.4 Calculul absorbanței

Absorbanță = −log₁₀ (intensitate_probă / intensitate_referință)

SMARTSPECTROMETER · GEO EDU LAB | 15

### 7. Calibrarea instrumentului

Calibrarea transformă pozițiile în pixeli din imagine în lungimi de undă reale (nanometri). Se face o singură dată per sesiune de lucru, după ce ați capturat și imaginile de măsurare și înainte de a analiza datele în Excel.

⚠️ Important: Nu mutați telefonul/camera după calibrare! Orice mișcare anulează calibrarea [1].

### 7.1 Surse de calibrare recomandate

Sursă | Lungime de undă (nm)
Pointer laser roșu | ≈650 nm
LED verde | ≈520 nm
LED albastru | ≈470 nm
Linii bec fluorescent | 436, 546, 578 nm

Folosiți două surse cu lungimi de undă cunoscute simultan și capturați imaginea lor.

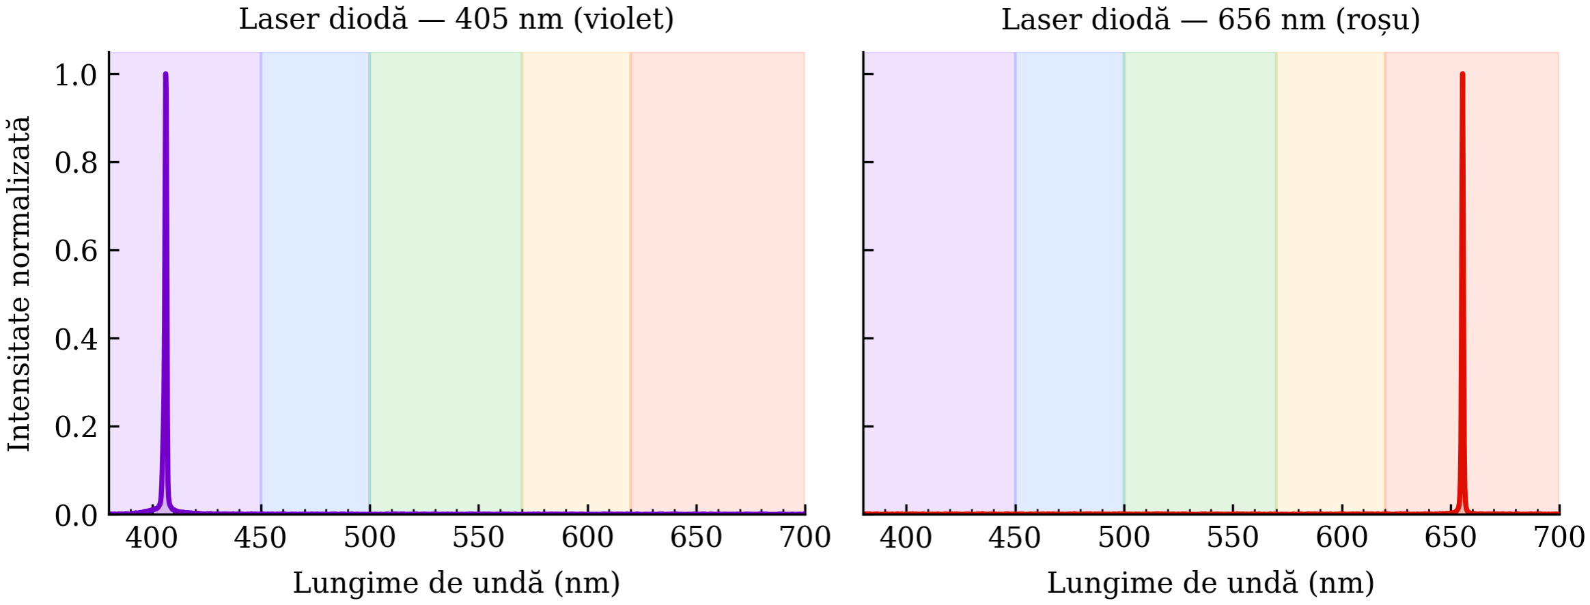
[picture p82: figure]

Fig. — Laserele roșu (656 nm) și violet (405 nm) produc linii înguste care servesc drept puncte de referință

pentru calibrare.

SMARTSPECTROMETER · GEO EDU LAB | 16

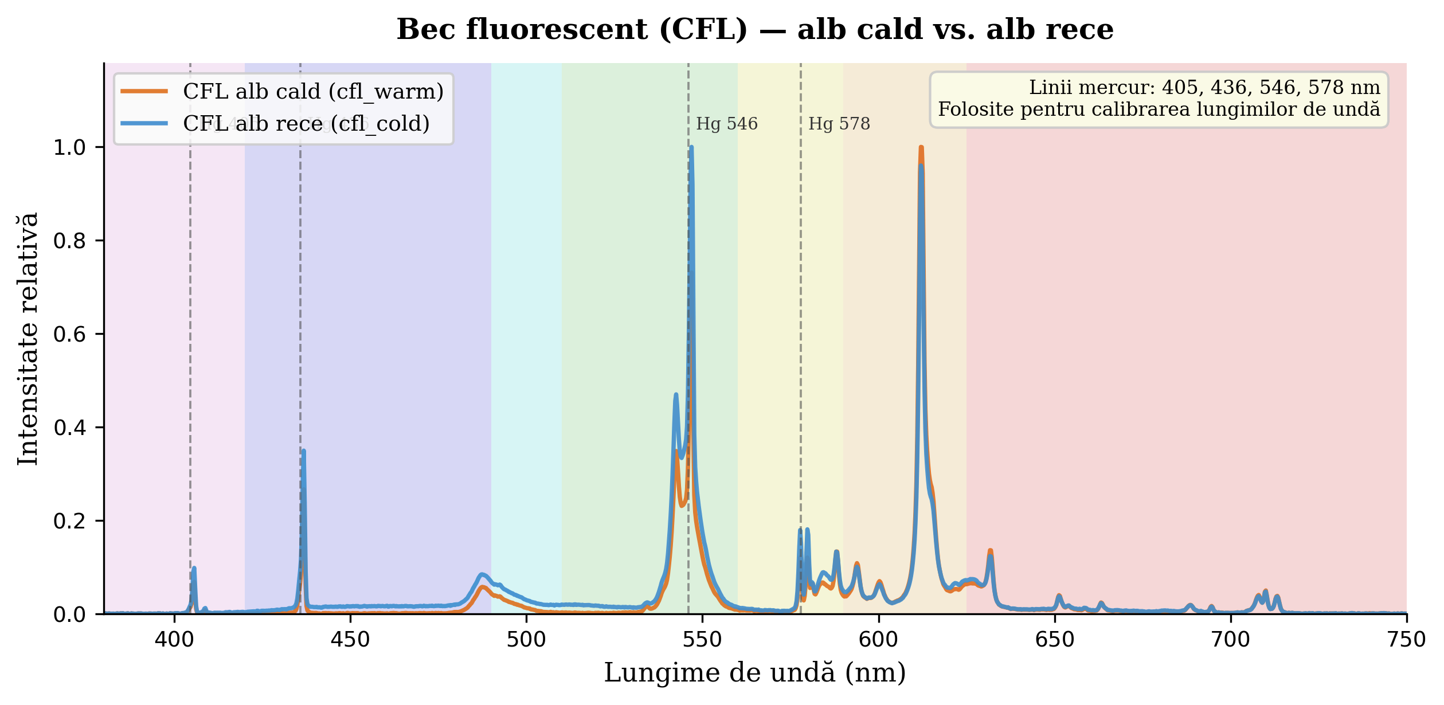
[picture p83: figure]

Fig. — Becul fluorescent produce linii de mercur (405, 436, 546, 578 nm) suprapuse pe un continuu larg dat de fosfor. Aceste linii sunt ideale pentru calibrare.

### 7.2 Calculul ecuației de calibrare

Identificați în graficul ImageJ pozițiile în pixeli ale celor două vârfuri de calibrare (p₁, p₂) și calculați [1]:

Pantă = (λ₂ − λ₁) / (p₂ − p₁)

λ(pixel) = Pantă × (pixel − p₁) + λ₁

Exemplu concret:

Laserul roșu (650 nm) → pixelul 820

LED-ul albastru (470 nm) → pixelul 340

Pantă = (650 − 470) / (820 − 340) = 180 / 480 = 0,375 nm/pixel

λ = 0,375 × (pixel − 340) + 470

Aplicați această ecuație coloanei de pixeli exportate din ImageJ pentru a obține coloana de lungimi de undă.

SMARTSPECTROMETER · GEO EDU LAB | 17

### 8. Experimente

Experiment 1: Spectroscopia de emisie — identificarea surselor de lumină

Concept: Fiecare tip de sursă de lumină produce un spectru caracteristic. Prin compararea spectrelor, putem identifica sursa și înțelege fizica din spatele acesteia.

Obiective:

Să observăm și să comparăm spectrele diferitelor surse de lumină
Să înțelegem diferența dintre spectrele continue și spectrele de linii

Să aplicăm calibrarea pentru a identifica lungimile de undă ale liniilor spectrale

Materiale: Spectrofotometrul asamblat, smartphone/cameră USB, surse de lumină diverse

Procedură:

1. Asamblați spectrofotometrul fără cuve (mod emisie)
2. Îndreptați spre fiecare sursă pe rând
3. Capturați imaginea spectrului
4. Calibrați și exportați datele din ImageJ
5. Trasați graficul intensitate vs. lungime de undă în Excel

### 1.1 Becul incandescent

Teoria: Becul incandescent funcționează prin încălzirea unui filament de wolfram la ≈2.700°C. La această temperatură, filamentul emite radiație de corp negru, un spectru continuu care acoperă toate lungimile de undă vizibile, cu intensitate mai mare în roșu și infraroșu.

💡 Știați că? Becul incandescent este extrem de ineficient energetic: 95% din energia consumată este emisă ca căldură (infraroșu), nu ca lumină vizibilă. De aceea a fost înlocuit de LED-uri!

SMARTSPECTROMETER · GEO EDU LAB | 18

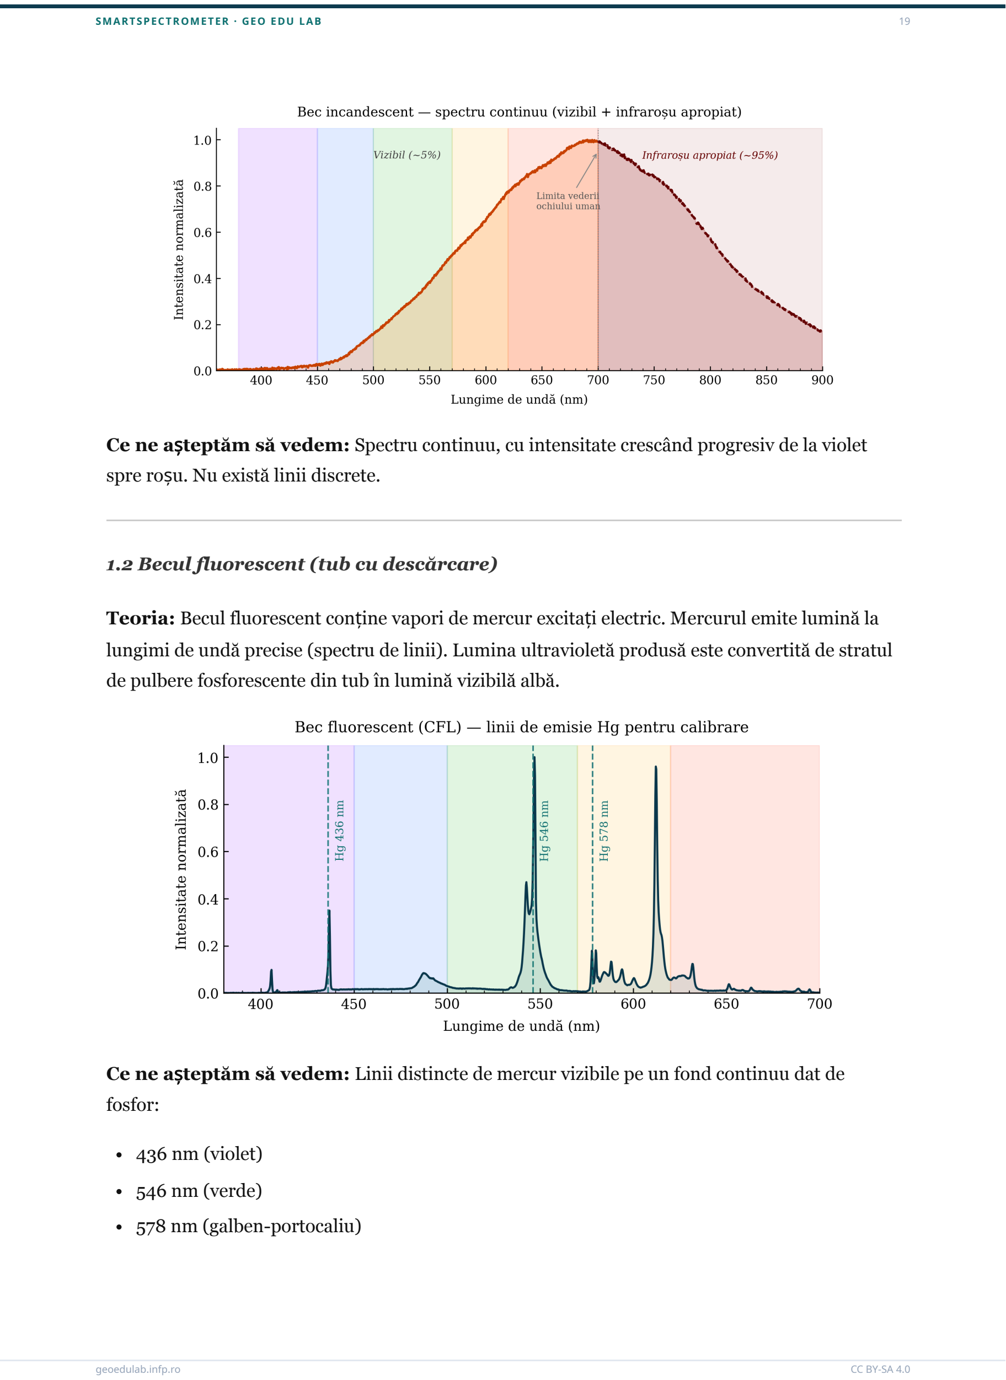
[picture p84: page 19]

Ce ne așteptăm să vedem: Spectru continuu, cu intensitate crescând progresiv de la violet spre roșu. Nu există linii discrete.

### 1.2 Becul fluorescent (tub cu descărcare)

Teoria: Becul fluorescent conține vapori de mercur excitați electric. Mercurul emite lumină la lungimi de undă precise (spectru de linii). Lumina ultravioletă produsă este convertită de stratul de pulbere fosforescente din tub în lumină vizibilă albă.

Ce ne așteptăm să vedem: Linii distincte de mercur vizibile pe un fond continuu dat de fosfor:

436 nm (violet)
546 nm (verde)
578 nm (galben-portocaliu)
SMARTSPECTROMETER · GEO EDU LAB | 19

💡 Știați că? Aceste linii de mercur sunt atât de precise și reproductibile încât pot fi folosite direct pentru calibrarea spectrofotometrului, fără a fi nevoie de lasere sau LED-uri de referință!

### 1.3 LED alb

Teoria: LED-ul alb nu emite de fapt alb; el combină un LED albastru (≈460 nm) cu un strat de fosfor galben care transformă o parte din lumina albastră în spectru larg galben-verde-roșu.

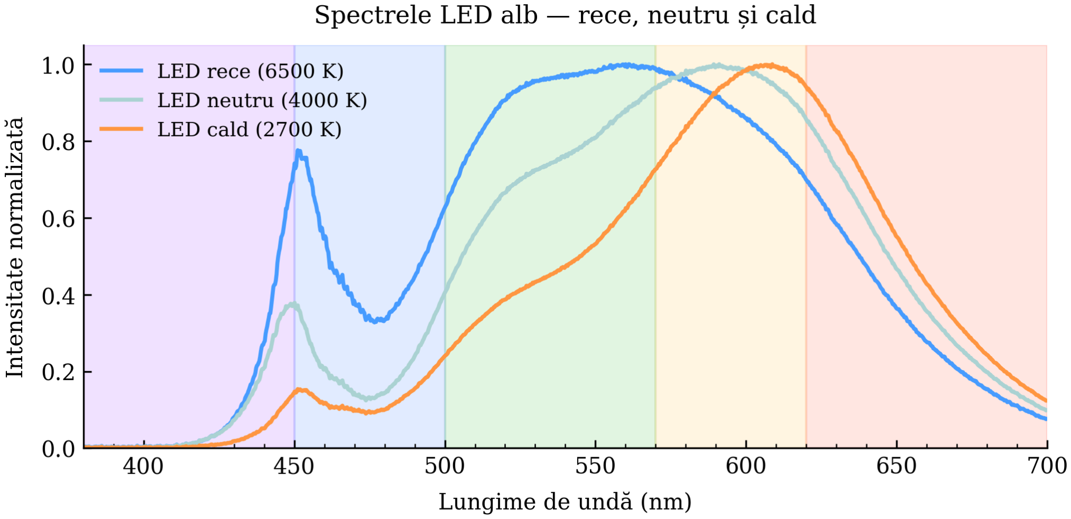
[picture p85: figure]

Ce ne așteptăm să vedem: Un vârf pronunțat în albastru (≈460 nm) și o bandă largă între 500–700 nm. Spectrul nu este continuu ca cel al becului incandescent.

### 1.4 LED-uri colorate (roșu, verde, albastru)

Teoria: Un LED colorat emite lumină aproape monocromatică, la o singură lungime de undă (sau o bandă îngustă). Lungimea de undă depinde de materialul semiconductor din care este construit.

Vezi figura de mai sus (1.3) — observați cum vârful albastru și banda de fosfor se deplasează între temperaturile de culoare rece, neutru și cald.

Ce ne așteptăm să vedem: Un singur vârf îngust la lungimea de undă caracteristică a LED-ului:

LED roșu: ≈620–660 nm

LED verde: ≈520–530 nm

SMARTSPECTROMETER · GEO EDU LAB | 20

LED albastru: ≈450–470 nm

💡 Știați că? Inventarea LED-ului albastru eficient de către Isamu Akasaki, Hiroshi Amano și Shuji Nakamura în anii 1990 a fost atât de revoluționară încât a fost recompensată cu Premiul Nobel pentru Fizică în 2014. Fără LED-ul albastru nu am fi putut fabrica LED-uri albe!

### 1.5 Lumina soarelui (indirectă)

Teoria: Soarele emite un spectru aproape continuu de corp negru la ≈5.500°C. Lumina traversează atmosfera solară și terestră, unde anumiți atomi absorb lungimi de undă precise, lăsând linii negre în spectru, liniile Fraunhofer.

⚠️ Nu îndreptați niciodată spectrofotometrul direct spre Soare! Folosiți lumina reflectată de un ecran alb mat sau o foaie de hârtie albă.

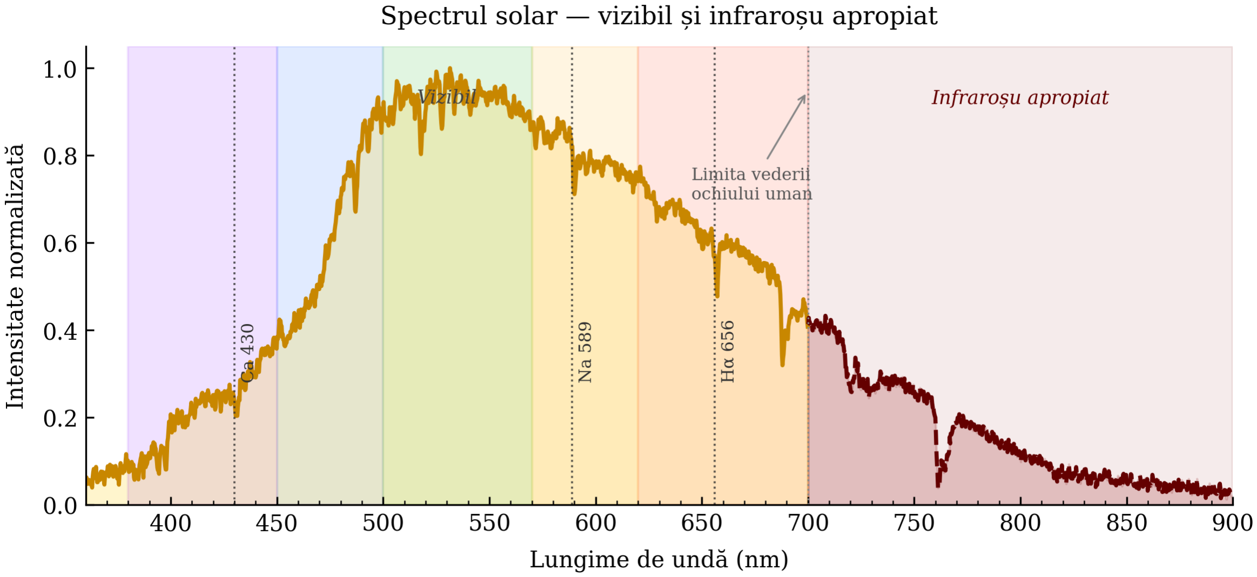
[picture p86: figure]

Ce ne așteptăm să vedem: Spectru continuu cu linii întunecate (absorbție) la:

589 nm (sodiu, linia D)
656 nm (hidrogen, linia Hα)
430 nm (calciu)
SMARTSPECTROMETER · GEO EDU LAB | 21

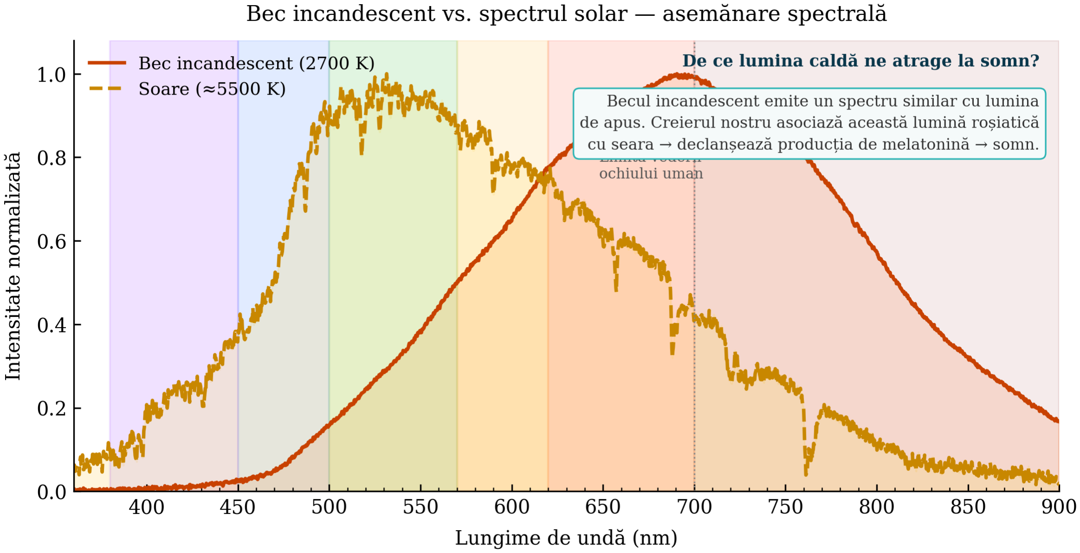
[picture p87: figure]

### 1.6 Flacăra lumânării sau a unui arzător Bunsen

Teoria: Flacăra emite lumină prin incandescența particulelor de carbon (fum) și prin emisiile atomice ale substanțelor arse. Adăugând săruri în flacără, putem produce linii de emisie caracteristice diferitelor elemente.

[Imaginea spectrului flacării — de capturat în timpul sesiunii de laborator]

Experiment suplimentar: Testul flacărei:

Introduceți în flacără câte puțin din: sare de bucătărie (NaCl → galben intens, 589 nm), sare de cupru (verde-albastru), sare de litiu (roșu)
Observați cum fiecare element produce o culoare caracteristică

💡 Știați că? Focurile de artificii sunt fabricate cu săruri metalice specifice pentru a produce culorile dorite: stronțiu → roșu, bariu → verde, sodiu → galben, cupru → albastru!

Experiment 2: Spectroscopia de absorbție — clorofila din frunze

Concept: Clorofila absoarbe selectiv anumite culori ale luminii pentru a alimenta fotosinteza.

Materiale: Frunze verzi, alcool (spirt) 90%, baie de apă caldă (≈50°C), cuvete, filtru de cafea

Procedură:

1. Tăiați mărunt frunzele verzi și puneți-le în alcool la 50°C timp de 20 min (baie de apă)
2. Filtrați printr-un filtru de cafea; obțineți un extract verde intens
SMARTSPECTROMETER · GEO EDU LAB | 22

3. Umpleți o cuvă cu extractul, alta cu alcool pur (referință)
4. Măsurați absorbția
5. Aplicați calibrarea și trasați graficul în Excel

Ce ne așteptăm să vedem: Maxime de absorbție la ≈430 nm (albastru) și ≈680 nm (roșu). Minim de absorbție (transmisie maximă) la ≈550 nm (verde, de aceea frunzele par verzi!).

💡 Știați că? Fotosinteza „preferă" anumite culori! Clorofila din frunze absoarbe cu precădere lumina roșie (≈680 nm) și albastră (≈430 nm), iar lumina verde este reflectată, de aceea plantele ne par verzi! Cu spectrofotometrul nostru putem măsura exact această absorbție.

Experiment 3: Legea Beer-Lambert — concentrație și absorbție

Concept: Cu cât o soluție este mai concentrată, cu atât absoarbe mai multă lumină; relație liniară.

Materiale: Cerneală albastră (sau sulfat de cupru CuSO₄), apă, 6 cuve, pipetă gradat

Procedură:

1. Preparați 5 soluții prin diluții succesive (1:2, 1:4, 1:8, 1:16, 1:32 față de soluția originală)
2. Măsurați absorbanța fiecăreia la lungimea de undă a maximului de absorbție
3. Trasați graficul: Absorbanță (axa Y) vs. Concentrație relativă (axa X)
4. Trasați linia de tendință; ar trebui să fie dreaptă (validarea legii Beer-Lambert)
5. Provocare: Preparați o soluție cu concentrație necunoscută și determinați-o din grafic!
SMARTSPECTROMETER · GEO EDU LAB | 23

### 9. Depanare: Ce fac dacă nu merge?

Problema observată | Cauza probabilă | Ce fac?
Piesele nu se potrivesc | Bavuri după imprimare | Curăț cu lamă/pilă (vezi Anexa B) [1]
Imaginea e neagră sau prea întunecată | Camera nealiniată sau expunere mică | Verific alinierea; cresc ISO-ul camerei
Imaginea e complet albă (supraexpusă) | Sursă prea puternică | Reduc ISO-ul sau timpul de expunere

Văd două spectre suprapuse

Folia din ramă e
orientată greșit

Desfac rama și rotesc bucata cu 90°; liniile trebuie să fie orizontale [1]

Spectrul e neclar, difuz | Focus greșit

Rotesc obiectivul camerei USB; curăț lentila smartphone-ului

Rezultatele variază între
sesiuni
Camera s-a mișcat | Recalibrez la fiecare sesiune nouă [1]

Lumina ambientală intră în instrument

Piese necomplet
introduse

Verific că toate piesele sunt bine fixate; folosesc DBS10

Fanta nu se vede deschisă / spectrul e foarte slab

Fanta tipărită s-a
închis parțial

Folosesc un cartonaș mai lat sau verific imprimanta cu cartonașul de probă

Calibrarea dă valori greșite

Vârfuri de calibrare
identificate greșit

Verific că p₁ corespunde lui λ₁ și p₂ lui λ₂

SMARTSPECTROMETER · GEO EDU LAB | 24

### 10. Referințe

[1] Winters, B.J., Banfield, N., Dixon, C., Swensen, A., Holman, D., & Fillbrown, B.
(2021). 3D-Printable and open-source modular smartphone visible spectrophotometer. HardwareX, 10,
e00232. https://doi.org/10.1016/j.ohx.2021.e00232

Resurse suplimentare:

Resursă | Link
Fișiere STL și documentație | https://osf.io/7ewb3
Piesele noi GeoEduLab (fante, ramă, jig) | https://github.com/GeoEduLab/3D-printed- Spectrometer/tree/main/new_parts (https://github.com/GeoEduLab/3D-printed-Spectrometer/tree/main/new_parts)
Software ImageJ | https://imagej.nih.gov/
Design CAD editabil online | https://www.onshape.com/
Comunitate open-source spectroscopie | https://publiclab.org
SMARTSPECTROMETER · GEO EDU LAB | 25
